gustavostuff/maki-nita/README.md

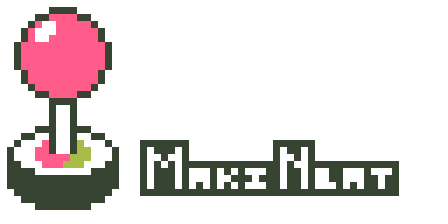
[picture p1: img/logos/logo_v_06_scaled.png]
Logo V6


MakiNeat is a cartridge-based, two-player portable tabletop Arcade. The name comes from _maquinita_ (pronounced very similarly), the Mexican word generally used for an arcade machine. The display is four white 8x8 LED matrices in a 16x16 field. Graphics are 1-bit (LEDs are either ON or OFF).

On a similar spirit as the Magnavox Odyssey and the Vectrex, MakiNeat uses colored, translucent sheets to cover the screen. So the overlay is an extension of the cartridge, part of the game experience. A magnetic marquee runs along the top and the cartridge sits behind it. The [overlays](docs/overlays.md) and [design](docs/design.md) docs cover the sheet and the system netlist.

An AVR128DB28 on a cartridge runs the game and holds the picture (the cartridge is both the system brain and the game data). Four MAX7219 drivers refresh the screen grid.

## Goals

Simple graphics + simple input can still be fun. A stick (and sometimes a button) is all that's needed. Together with cartridges, colored overlays, and a sturdy design, that is the spirit of MakiNeat.

The build is a simple soldering job.

- Parts are through-hole, on a 2.54 mm grid.
- Chips sit in sockets, so a bad one can be swapped.
- Wires leave the board on headers. Two for player controls, another one for power/reset, and one more for the speaker.

Parts are cheap.

- The main system board is a two-layer 100x100 mm board (~5 USD + shipping). The cartridge is an even smaller PCB.
- The screen is four white 8x8 LED matrices (normally less than 1 USD each), and the chips are commonly available (not EOL or NRND).

- Power is any generic/regulated 5 V adapter.

Software is under the MIT License. The hardware design is under the CERN Open Hardware Licence Version 2, Strongly Reciprocal.

## PCBs

Copper tracing is still a WIP for the main PCB, but the full [SKiDL netlist](tools/kicad/main-pcb/skidl/makineat.py) and KiCad files are already under `tools/kicad/main-pcb/` and `tools/kicad/cart-pcb/` (not tested IRL).

Main system PCB, 100x100 mm:

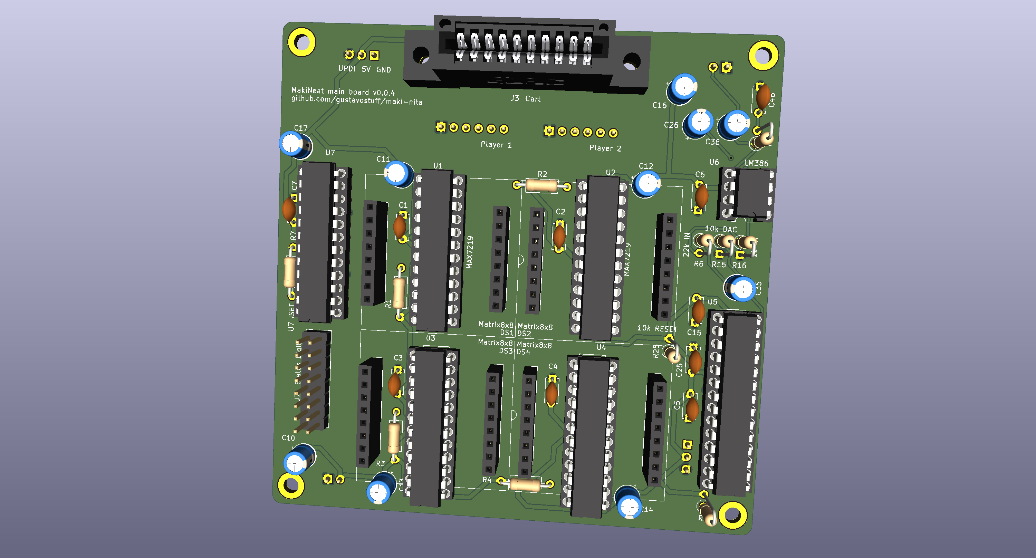
[picture p2: img/pcb/main_pcb_concept.png]
Main PCB concept


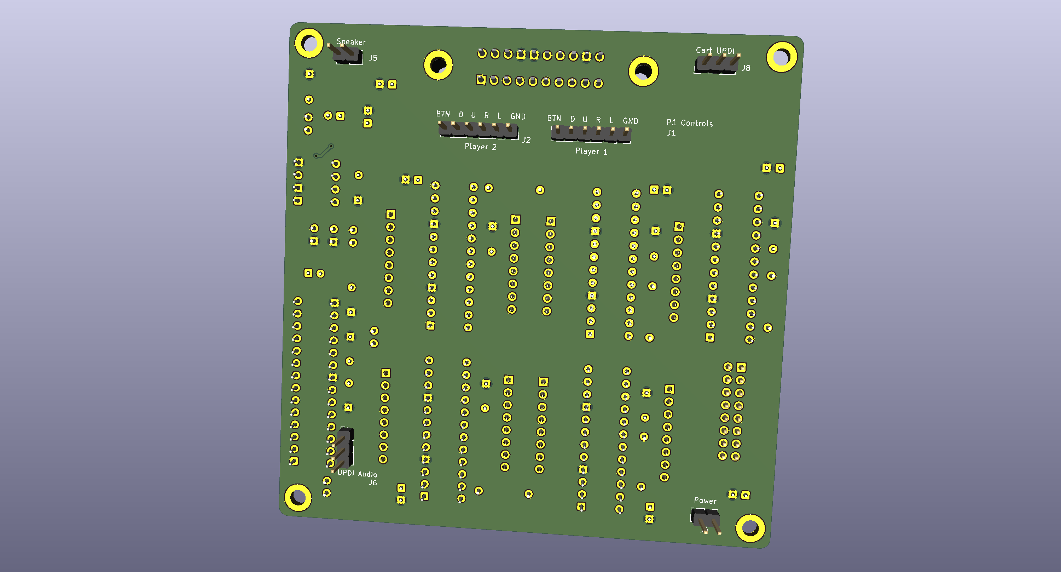
[picture p3: img/pcb/main_pcb_concept_back.png]
Main PCB concept


Cartridge PCB, 44x37 mm:

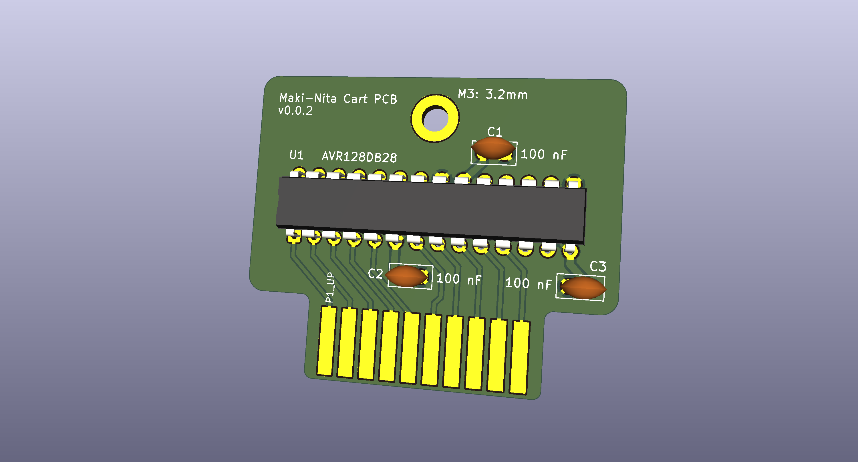
[picture p4: img/pcb/cart_pcb_concept.png]
Cart PCB concept


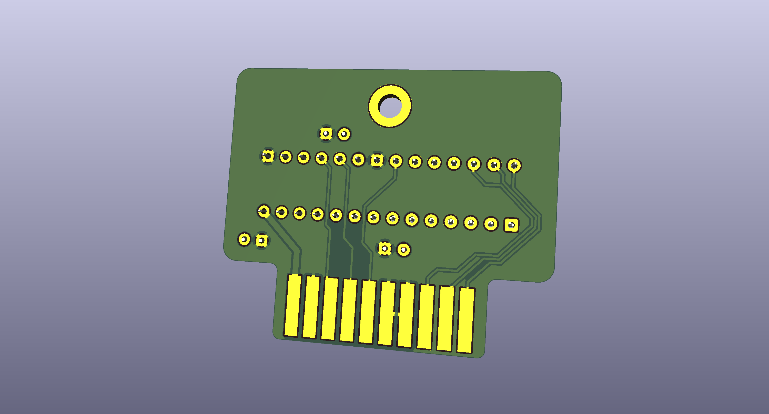
[picture p5: img/pcb/cart_pcb_concept_back.png]
Cart PCB concept back


## Game simulator

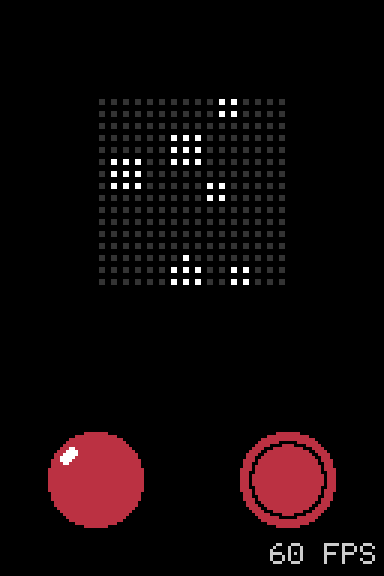
[picture p6: img/sim/sim.png]
Simulator


`tools/sim` is a netlist simulation of the system. The simulator compiles the cartridge's C game code natively on the host to drive the hardware model. This same C code can be directly flashed to the AVR on the cartridge.

SKiDL export writes `tools/kicad/main-pcb/skidl/makineat.net` and updates net classes in `tools/kicad/main-pcb/makineat_v_04.kicad_pro`. See [firmware](docs/firmware.md).

`./sim.sh` opens the UI. The active cart is named in `cart_placed.json`.

## Screen overlay

Physical translucent sheets, placed in front of the white matrix LEDs and status digits, make multi-colored graphics. A single framed overlay holds colored acetate cutouts across both zones, with game labels along the frame:

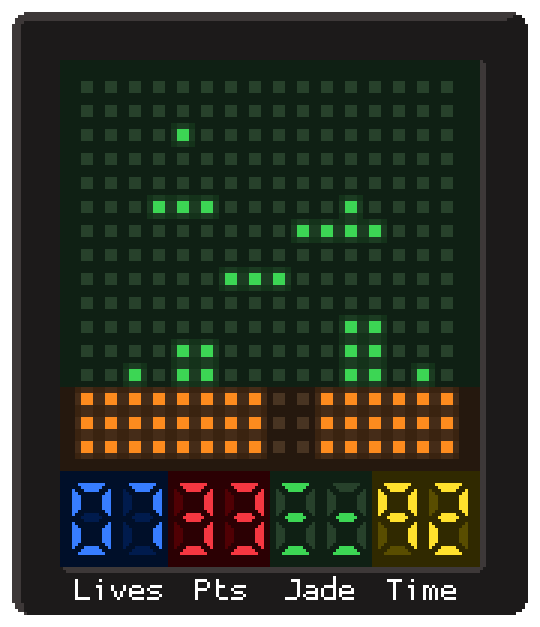
[picture p7: img/acetate_examples/Full_overlay_example.png]
Full overlay example


## Docs

- [Design](docs/design.md) is the system netlist, cart edge, display chain, and audio wiring from SKiDL and KiCad.
- [Firmware](docs/firmware.md) is the game loop, inputs, sound, SDK, and simulator.
- [Overlays](docs/overlays.md) is the colored sheet in front of the field.
- [Future plans](docs/future-plans.md) is the hardware and firmware enhancement roadmap.
- [Status digits](docs/status-digits.md) is the fifth driver and 7-segment display proposal.
- [Driver to matrix pinout](docs/driver_to_matrix_pinout.md) is the MAX7219 and 1088AS LED matrix pinout and activation reference.
