gustavostuff/maki-nita/docs/firmware.md

# Firmware and simulator

Sources live under `tools/fw/`. Cartridge game firmware runs on the cartridge AVR128DB28 at 12 MHz, while system audio synthesis runs on the AVR128DB28 at 20 MHz.

## Game loop and display refresh

The runtime loops at 60 Hz (~16.67 ms per frame). Each pass debounces inputs, executes `game_tick`, and flushes the 16x16 framebuffer across the MAX7219 chain.

The framebuffer is sixteen rows of sixteen bits in `frame[16]`. `pixel`, `pixel_get`, and `clear` form the drawing API. There is no per-pixel brightness in RAM.

DIN is PA4, CLK is PA6, LOAD is PA7. One flush transmits eight digit rows across all four drivers via SPI. During init, firmware configures:
- Decode mode register (0x09) to 0x00 (raw matrix drive, no BCD decode).
- Scan limit register (0x0B) to 0x07 (scan all 8 digits).
- Shutdown register (0x0C) to 0x01 (normal operation).
- Intensity register (0x0A) defaults to 0x0F (full intensity).

### Refresh rate and timing

The MAX7219 uses an autonomous internal RC oscillator with a nominal multiplex scan rate of ~800 Hz (~1.25 ms per full 8-row cycle). This scan frequency is fixed in hardware by internal silicon timing and cannot be reconfigured via register writes.

In relation to the 60 Hz game loop:
- During each 16.67 ms game frame, the MAX7219 hardware autonomously multiplexes the LED rows approximately 13.3 times.
- Because data is double-buffered within the driver registers and latched atomically on the rising edge of LOAD, frame updates never tear or glitch across row scan cycles.
- Operating the hardware multiplexer at ~800 Hz keeps scanning well above human flicker fusion thresholds while completely decoupling LED scanning from CPU frame execution.

## Inputs and debouncing

Player 1 and Player 2 stick and action button nets reach dedicated input pins on the cartridge AVR (ten switch inputs in total). Each switch is active low with an internal pull-up.

Debouncing in `tools/fw/input.c` samples inputs once per 60 Hz tick. Two consecutive disagreeing ticks are required before a state change registers, providing approximately 33 ms of noise immunity.

The planned system brightness control uses debounced input on the Bright button and stick. Tapping the Bright button advances brightness to the next level (wrapping from 15 to 1). Holding the Bright button while pressing stick Up or Down steps the level up or down. Levels are 1, 3, 5, 7, 9, 11, 13, and 15 across all four MAX7219 parts. Zero is not used. Bright and intensity writes are not in the SKiDL netlist yet. The simulator does not model Brightness.

## Sound

Games call `sound(index)` with a catalog index 0 through 255. Index 0 is silent. Sound definitions live in `tools/fw/synth.c`. The cartridge transmits index bytes across the EVENT line as eight low pulses (100 us or 200 us wide). The system audio AVR samples EVENT at 40 kHz, decodes the index, and mixes square wave, triangle wave, and pseudo-random noise channels at 20 kHz into the 10-bit DAC output on PD6.

## Entity SDK

Games can use `tools/fw/entity.c` for sprite movement and collisions, supporting up to 64 active slots. A 32 by 32 coordinate space wraps the screen with an 8 LED/pixel margin on every side. `world_draw` copies the center 16 by 16 playfield into `frame`. Shapes are up to 4 by 4, packed with `SHAPE1` through `SHAPE4`. Functions `entity_spawn`, `entity_step`, `world_tick`, and `world_pairs` manage motion and collision testing.

## Carts

Each cart implements `void game_tick(const Input *in)`. Test carts configured in `cart_placed.json` are `space-shooter`, `paddle`, and `arkaled`.
- Build cartridge firmware with `make -C tools/fw/avr` or `make -C tools/fw/avr CART=paddle`.
- Build system audio firmware with `make -C tools/fw/audio`.

## Flashing hardware (UPDI)

Both microcontrollers (cartridge AVR on J8 and audio AVR on J6) use identical 3-pin headers:
- Pin 1: UPDI
- Pin 2: +5V
- Pin 3: GND

Recommended low-cost programmers:
1. **Adafruit UPDI Friend**: Compact USB-C/micro-USB to UPDI programmer with built-in bidirectional resistor/diode network and selectable 3.3V/5V target power. Connects directly to J6 or J8 via a 3-wire cable.
2. **HiLetgo CH340 USB-UART adapter (SerialUPDI)**: Low-cost USB-to-serial adapter. Connect TX through a 4.7 kohm resistor to RX to form the single bidirectional UPDI line (Pin 1), with 5V on Pin 2 and GND on Pin 3.

Flash commands using `pymcuprog`:
```bash
# Flash cartridge game (with cart seated in J3, programmer plugged into J8):
pymcuprog write -d avr128db28 -t uart -u /dev/ttyACM0 --verify -f tools/fw/avr/game.hex

# Flash console audio synthesis (programmer plugged into J6):
pymcuprog write -d avr128db28 -t uart -u /dev/ttyACM0 --verify -f tools/fw/audio/audio.hex
```

## Simulator

`./sim.sh` builds and launches `tools/sim/makineat-ui`. The netlist model connects simulated cartridge pins to U1 through U4, EVENT, and J5. Host simulation runs at 60 Hz with 12 MHz and 20 MHz timing constants defined in `tools/sim/clocks.h`.
