gustavostuff/maki-nita/acetate_screenshot.png

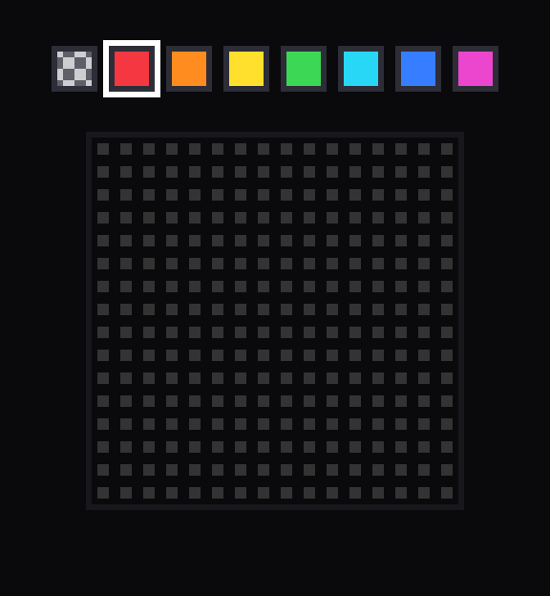
acetate_screenshot.png
