gustavostuff/maki-nita/img/acetate_examples/frog-led.png

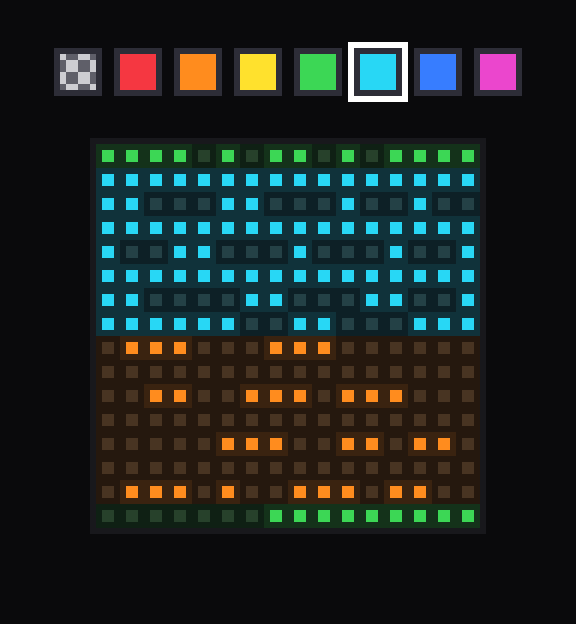
img/acetate_examples/frog-led.png
