gustavostuff/maki-nita/img/acetate_examples/ledtris.png

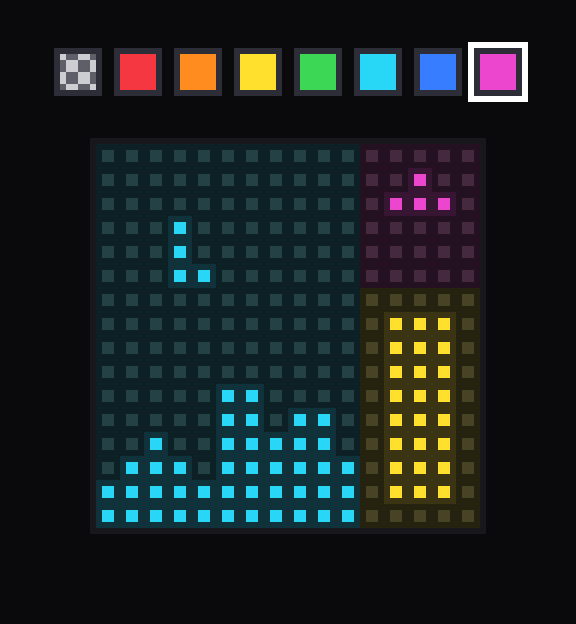
img/acetate_examples/ledtris.png
