gustavostuff/maki-nita/img/acetate_examples/super-led-bros.png

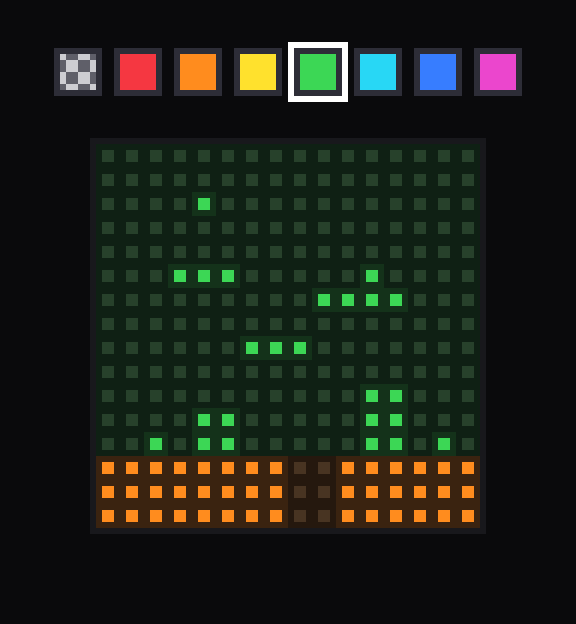
img/acetate_examples/super-led-bros.png
