gustavostuff/maki-nita/img/game_ideas/super-led-bros-grid.png

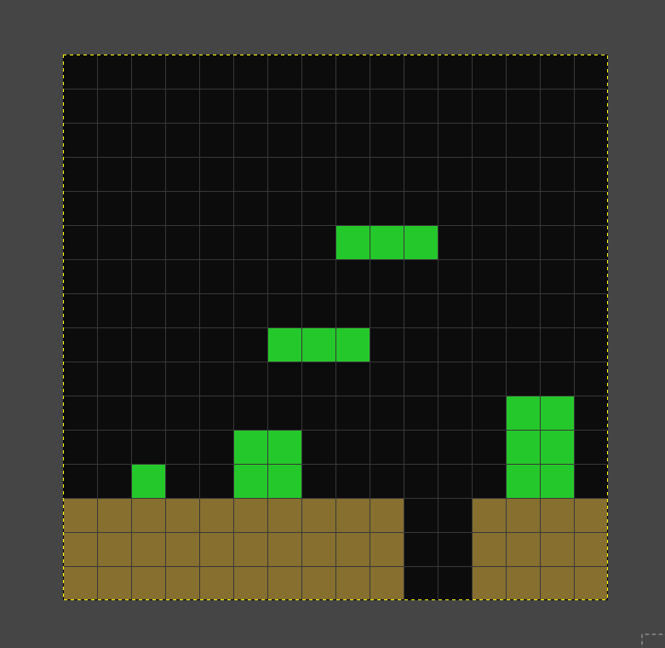
img/game_ideas/super-led-bros-grid.png
