gustavostuff/maki-nita/img/references/JST_XH_power_port.png

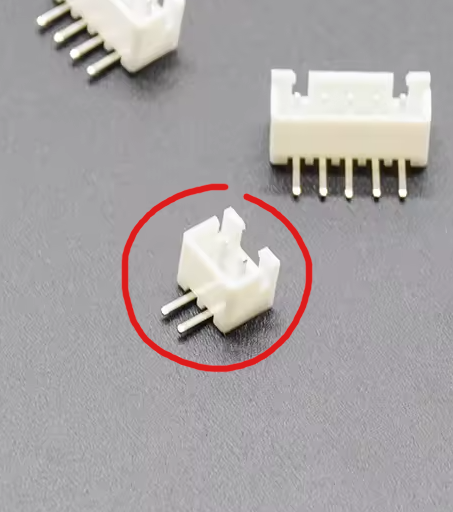
img/references/JST_XH_power_port.png
