gustavostuff/maki-nita/tools/kicad/main-pcb/makineat.kicad_pcb

## KiCad design tools/kicad/main-pcb/makineat.kicad_pcb (2026-10-30, an earlier design)

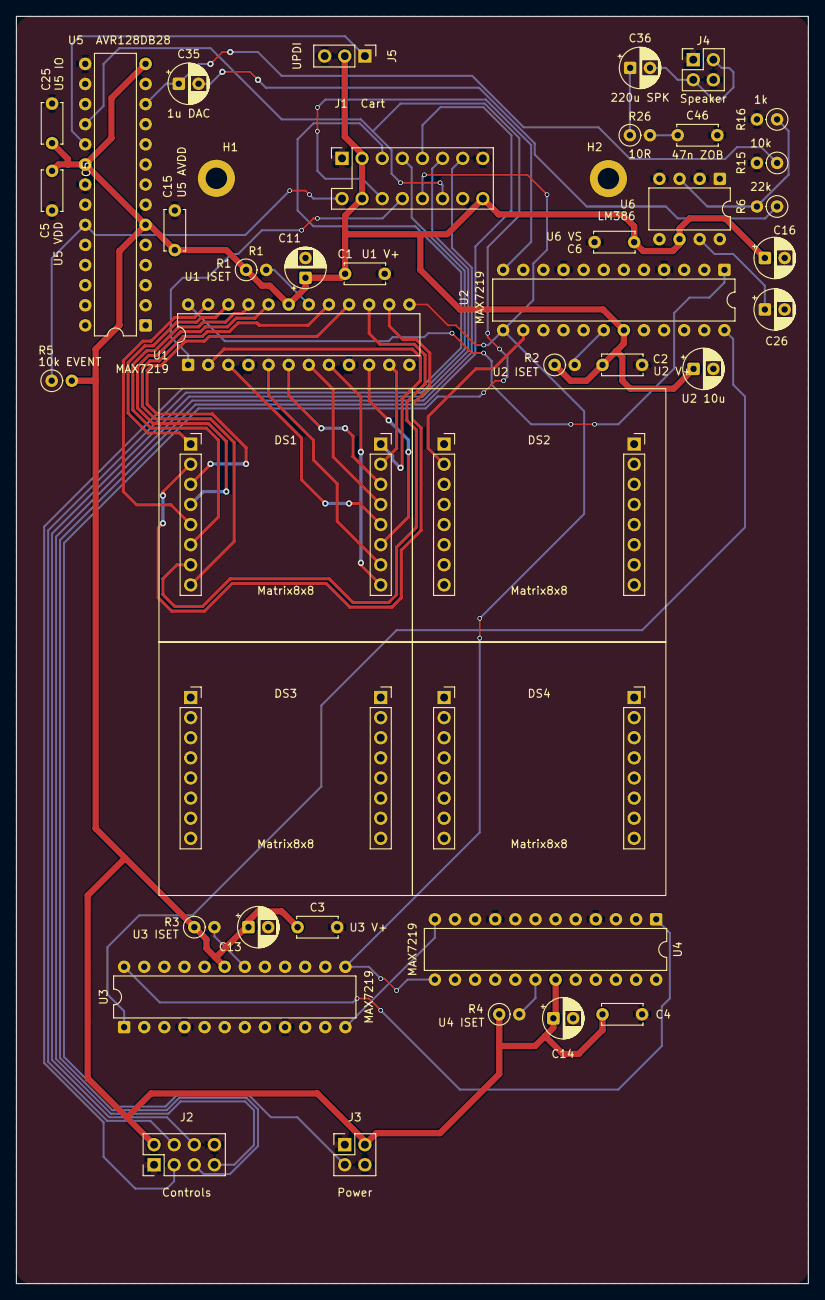
[picture p16: board makineat.kicad_pcb from above]

Board: 2 copper layers, 100.0 x 160.0 mm, 43 parts (0 on the bottom side), 91 nets.

Parts:
C1: U1 V+; C_Disc_D5.0mm_W2.5mm_P5.00mm
C2: U2 V+; C_Disc_D5.0mm_W2.5mm_P5.00mm
C3: U3 V+; C_Disc_D5.0mm_W2.5mm_P5.00mm
C4: U4 V+; C_Disc_D5.0mm_W2.5mm_P5.00mm
C5: U5 VDD; C_Disc_D5.0mm_W2.5mm_P5.00mm
C6: U6 VS; C_Disc_D5.0mm_W2.5mm_P5.00mm
C11: U1 10u; CP_Radial_D5.0mm_P2.50mm
C12: U2 10u; CP_Radial_D5.0mm_P2.50mm
C13: U3; CP_Radial_D5.0mm_P2.50mm
C14: U4 10u; CP_Radial_D5.0mm_P2.50mm
C15: U5 AVDD; C_Disc_D5.0mm_W2.5mm_P5.00mm
C16: U6 VS; CP_Radial_D5.0mm_P2.50mm
C25: U5 IO; C_Disc_D5.0mm_W2.5mm_P5.00mm
C26: U6 BYP; CP_Radial_D5.0mm_P2.50mm
C35: 1u DAC; CP_Radial_D5.0mm_P2.50mm
C36: 220u SPK; CP_Radial_D5.0mm_P2.50mm
C46: 47n ZOB; C_Disc_D5.0mm_W2.5mm_P5.00mm
DS1, DS2, DS3, DS4: Matrix8x8; Matrix8x8_2x8_P2.52mm_R25mm
H1, H2: MountingHole_2.7mm_M2.5_DIN965_Pad
J1: Cart; EDAC_345_MoboSocket_2x8_2.54x5.08mm
J2: Controls; PinHeader_2x04_P2.54mm_Vertical
J3: Power; PinHeader_2x02_P2.54mm_Vertical
J4: Speaker; PinHeader_2x02_P2.54mm_Vertical
J5: UPDI; PinHeader_1x03_P2.54mm_Vertical
R1: U1 ISET; R_Axial_DIN0207_L6.3mm_D2.5mm_P2.54mm_Vertical
R2: U2 ISET; R_Axial_DIN0207_L6.3mm_D2.5mm_P2.54mm_Vertical
R3: U3 ISET; R_Axial_DIN0207_L6.3mm_D2.5mm_P2.54mm_Vertical
R4: U4 ISET; R_Axial_DIN0207_L6.3mm_D2.5mm_P2.54mm_Vertical
R5: 10k EVENT; R_Axial_DIN0207_L6.3mm_D2.5mm_P2.54mm_Vertical
R6: 22k; R_Axial_DIN0207_L6.3mm_D2.5mm_P2.54mm_Vertical
R15: 10k; R_Axial_DIN0207_L6.3mm_D2.5mm_P2.54mm_Vertical
R16: 1k; R_Axial_DIN0207_L6.3mm_D2.5mm_P2.54mm_Vertical
R26: 10R; R_Axial_DIN0207_L6.3mm_D2.5mm_P2.54mm_Vertical
U1, U2, U3, U4: MAX7219; DIP-24_W7.62mm
U5  AVR128DB28: Audio AVR; DIP-28_W7.62mm
U6: LM386; DIP-8_W7.62mm

Connections:
+5V: C1.1, C2.1, C3.1, C4.1, C5.1, C6.1, C11.1, C12.1, C13.1, C14.1, C15.1, C16.1, C25.1, J1.3, J1.4, J1.16, J2.2, J3.2, J5.2, R1.1, R2.1, R3.1, R4.1, R5.2, U1.19, U2.19, U3.19, U4.19, U5 AVR128DB28.6, U5 AVR128DB28.14, U5 AVR128DB28.20, U6.6
AMP: C36.1, R26.1, U6.5
AUD: C35.2, R6.1
AUDIN: R6.2, R16.1, U6.3
AUDIO_UPDI: J5.1, U5 AVR128DB28.19
BUTTON: J1.13, J2.7
BYPASS: C26.1, U6.7
CLK: J1.10, U1.13, U2.13, U3.13, U4.13
DAC: C35.1, R15.1, U5 AVR128DB28.12
DIN: J1.8, U1.1
DOUT_U1: U1.24, U2.1
DOUT_U2: U2.24, U3.1
DOUT_U3: U3.24, U4.1
DOWN: J1.7, J2.4
DS1_C0: DS1.1, U1.22
DS1_C1: DS1.2, U1.14
DS1_C2: DS1.3, U1.16
DS1_C3: DS1.4, U1.20
DS1_C4: DS1.5, U1.23
DS1_C5: DS1.6, U1.21
DS1_C6: DS1.7, U1.15
DS1_C7: DS1.8, U1.17
DS1_R0: DS1.16, U1.2
DS1_R1: DS1.15, U1.11
DS1_R2: DS1.14, U1.6
DS1_R3: DS1.13, U1.7
DS1_R4: DS1.12, U1.3
DS1_R5: DS1.11, U1.10
DS1_R6: DS1.10, U1.5
DS1_R7: DS1.9, U1.8
DS2_C0: DS2.1, U2.22
DS2_C1: DS2.2, U2.14
DS2_C2: DS2.3, U2.16
DS2_C3: DS2.4, U2.20
DS2_C4: DS2.5, U2.23
DS2_C5: DS2.6, U2.21
DS2_C6: DS2.7, U2.15
DS2_C7: DS2.8, U2.17
DS2_R0: DS2.16, U2.2
DS2_R1: DS2.15, U2.11
DS2_R2: DS2.14, U2.6
DS2_R3: DS2.13, U2.7
DS2_R4: DS2.12, U2.3
DS2_R5: DS2.11, U2.10
DS2_R6: DS2.10, U2.5
DS2_R7: DS2.9, U2.8
DS3_C0: DS3.1, U3.22
DS3_C1: DS3.2, U3.14
DS3_C2: DS3.3, U3.16
DS3_C3: DS3.4, U3.20
DS3_C4: DS3.5, U3.23
DS3_C5: DS3.6, U3.21
DS3_C6: DS3.7, U3.15
DS3_C7: DS3.8, U3.17
DS3_R0: DS3.16, U3.2
DS3_R1: DS3.15, U3.11
DS3_R2: DS3.14, U3.6
DS3_R3: DS3.13, U3.7
DS3_R4: DS3.12, U3.3
DS3_R5: DS3.11, U3.10
DS3_R6: DS3.10, U3.5
DS3_R7: DS3.9, U3.8
DS4_C0: DS4.1, U4.22
DS4_C1: DS4.2, U4.14
DS4_C2: DS4.3, U4.16
DS4_C3: DS4.4, U4.20
DS4_C4: DS4.5, U4.23
DS4_C5: DS4.6, U4.21
DS4_C6: DS4.7, U4.15
DS4_C7: DS4.8, U4.17
DS4_R0: DS4.16, U4.2
DS4_R1: DS4.15, U4.11
DS4_R2: DS4.14, U4.6
DS4_R3: DS4.13, U4.7
DS4_R4: DS4.12, U4.3
DS4_R5: DS4.11, U4.10
DS4_R6: DS4.10, U4.5
DS4_R7: DS4.9, U4.8
EVENT: J1.2, R5.1, U5 AVR128DB28.23
GND: C1.2, C2.2, C3.2, C4.2, C5.2, C6.2, C11.2, C12.2, C13.2, C14.2, C15.2, C16.2, C25.2, C26.2, C46.2, J1.1, J1.15, J2.1, J2.8, J3.1, J3.4, J4.1, J4.4, J5.3, R15.2, R16.2, U1.4, U1.9, U2.4, U2.9, U3.4, U3.9, U4.4, U4.9, U5 AVR128DB28.15, U5 AVR128DB28.21, U6.2, U6.4
LEFT: J1.9, J2.5
LOAD: J1.6, U1.12, U2.12, U3.12, U4.12
RESET: J1.12, J3.3, U5 AVR128DB28.18
RIGHT: J1.11, J2.6
SPK: C36.2, J4.2, J4.3
U1_ISET: R1.2, U1.18
U2_ISET: R2.2, U2.18
U3_ISET: R3.2, U3.18
U4_ISET: R4.2, U4.18
UP: J1.5, J2.3
ZOBEL: C46.1, R26.2
