gustavostuff/maki-nita/tools/kicad/main-pcb/makineat_v_04.kicad_pcb

## KiCad design tools/kicad/main-pcb/makineat_v_04.kicad_pcb (2026-10-31)

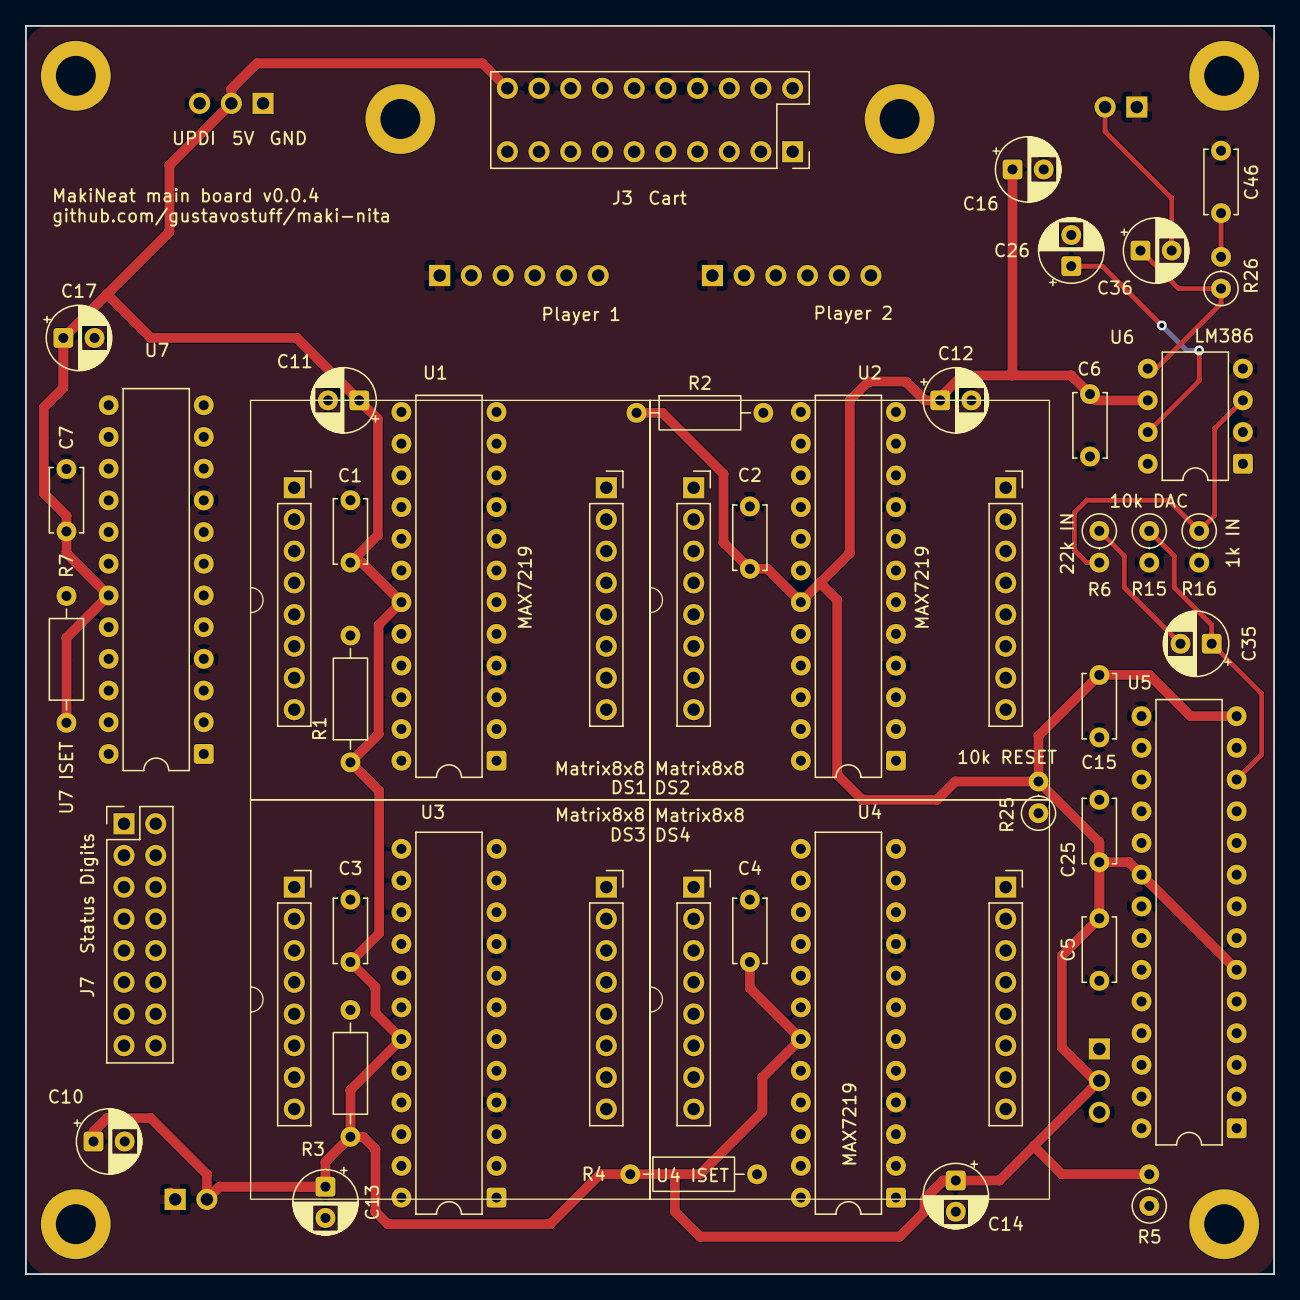
[picture p18: board makineat_v_04.kicad_pcb from above]

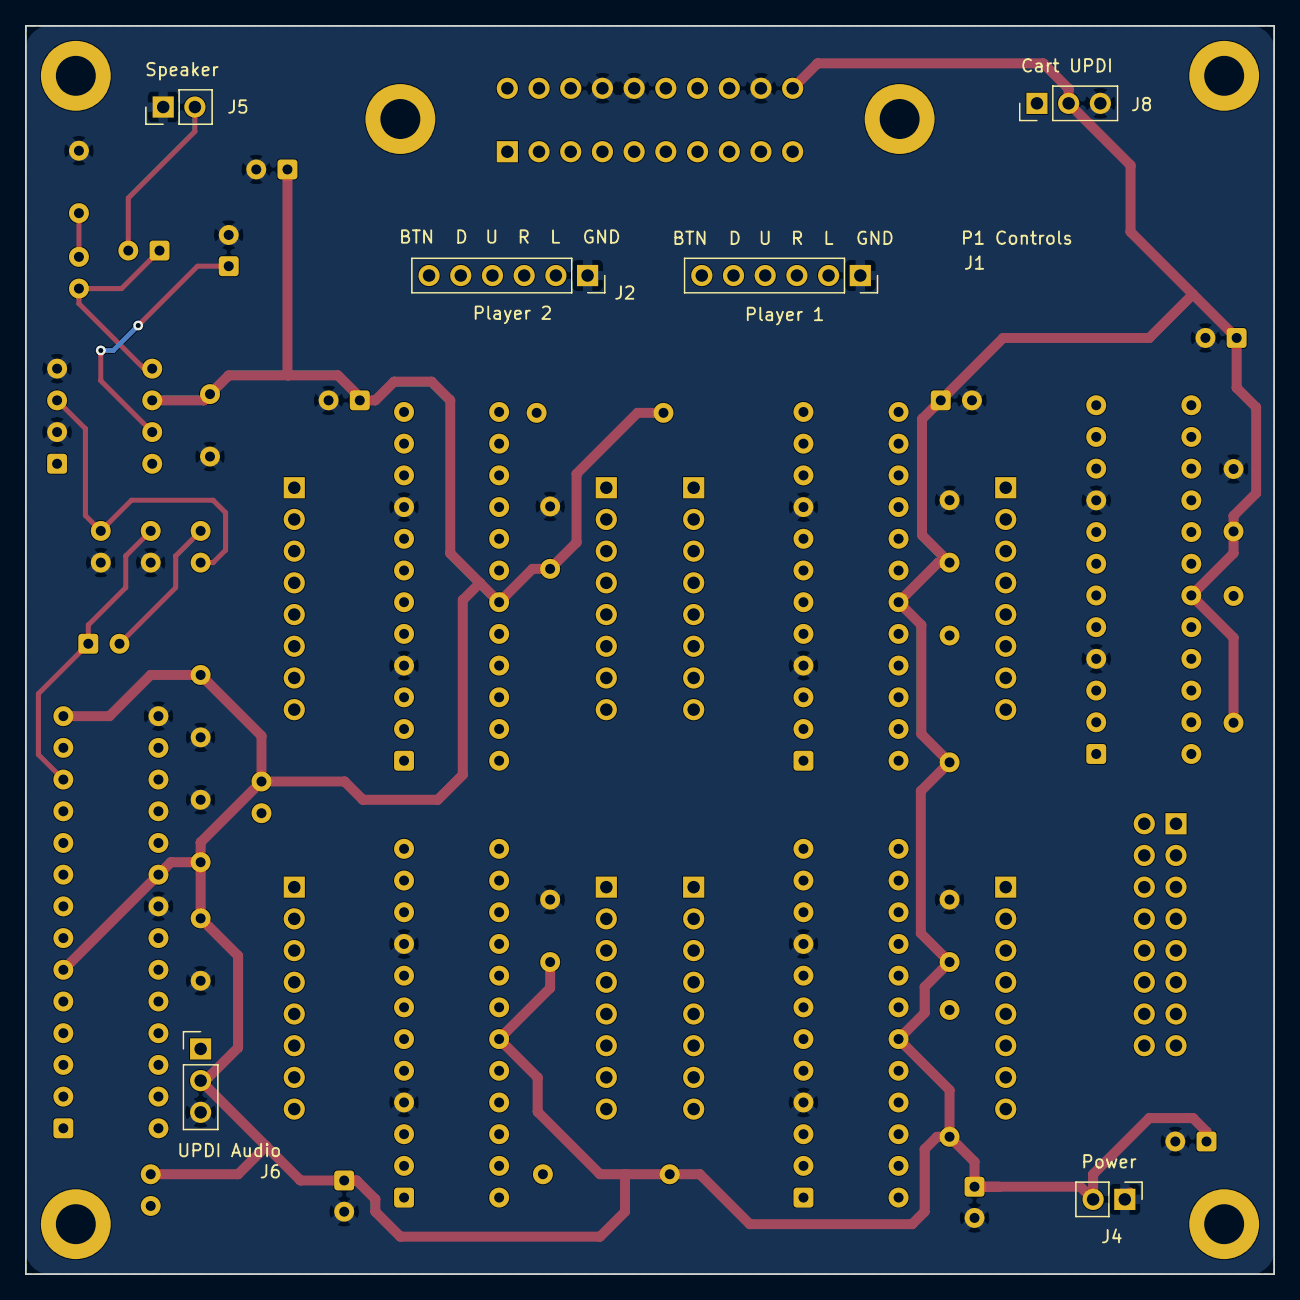
[picture p19: board makineat_v_04.kicad_pcb from below]

Board: 2 copper layers, 100.0 x 100.0 mm, 50 parts (6 on the bottom side), 115 nets.

Parts:
C1: U1 V+; C_Disc_D5.0mm_W2.5mm_P5.00mm
C2: U2 V+; C_Disc_D5.0mm_W2.5mm_P5.00mm
C3: U3 V+; C_Disc_D5.0mm_W2.5mm_P5.00mm
C4: U4 V+; C_Disc_D5.0mm_W2.5mm_P5.00mm
C5: U5 VDD; C_Disc_D5.0mm_W2.5mm_P5.00mm
C6: U6 VS; C_Disc_D5.0mm_W2.5mm_P5.00mm
C7: U7 V+; C_Disc_D5.0mm_W2.5mm_P5.00mm
C10: 470u VCC; CP_Radial_D5.0mm_P2.50mm
C11: U1 10u; CP_Radial_D5.0mm_P2.50mm
C12: U2 10u; CP_Radial_D5.0mm_P2.50mm
C13: U3 10u; CP_Radial_D5.0mm_P2.50mm
C14: U4 10u; CP_Radial_D5.0mm_P2.50mm
C15: U5 AVDD; C_Disc_D5.0mm_W2.5mm_P5.00mm
C16: U6 VS; CP_Radial_D5.0mm_P2.50mm
C17: U7 10u; CP_Radial_D5.0mm_P2.50mm
C25: U5 IO; C_Disc_D5.0mm_W2.5mm_P5.00mm
C26: U6 BYP; CP_Radial_D5.0mm_P2.50mm
C35: 1u DAC; CP_Radial_D5.0mm_P2.50mm
C36: 220u SPK; CP_Radial_D5.0mm_P2.50mm
C46: 47n ZOB; C_Disc_D5.0mm_W2.5mm_P5.00mm
DS1, DS2, DS3, DS4: Matrix8x8; Matrix8x8_2x8_P2.52mm_R25mm
J1: P1 Controls; PinHeader_1x06_P2.54mm_Vertical
J2: P2 Controls; PinHeader_1x06_P2.54mm_Vertical
J3: Cart; EDAC_395_MoboSocket_2x10_2.54x5.08mm
J4: Power; PinHeader_1x02_P2.54mm_Vertical
J5: Speaker; PinHeader_1x02_P2.54mm_Vertical
J6: UPDI Audio; PinHeader_1x03_P2.54mm_Vertical
J7: Status Digits; PinHeader_2x08_P2.54mm_Vertical
J8: Cart UPDI; PinHeader_1x03_P2.54mm_Vertical
R1: U1 ISET; R_Axial_DIN0207_L6.3mm_D2.5mm_P10.16mm_Horizontal
R2: U2 ISET; R_Axial_DIN0207_L6.3mm_D2.5mm_P10.16mm_Horizontal
R3: U3 ISET; R_Axial_DIN0207_L6.3mm_D2.5mm_P10.16mm_Horizontal
R4: U4 ISET; R_Axial_DIN0207_L6.3mm_D2.5mm_P10.16mm_Horizontal
R5: 10k EVENT; R_Axial_DIN0207_L6.3mm_D2.5mm_P2.54mm_Vertical
R6: 22k IN; R_Axial_DIN0207_L6.3mm_D2.5mm_P2.54mm_Vertical
R7: U7 ISET; R_Axial_DIN0207_L6.3mm_D2.5mm_P10.16mm_Horizontal
R15: 10k DAC; R_Axial_DIN0207_L6.3mm_D2.5mm_P2.54mm_Vertical
R16: 1k IN; R_Axial_DIN0207_L6.3mm_D2.5mm_P2.54mm_Vertical
R25: 10k RESET; R_Axial_DIN0207_L6.3mm_D2.5mm_P2.54mm_Vertical
R26: 10R ZOB; R_Axial_DIN0207_L6.3mm_D2.5mm_P2.54mm_Vertical
U1, U2, U3, U4, U7: MAX7219; DIP-24_W7.62mm
U5: Audio AVR; DIP-28_W7.62mm
U6: LM386; DIP-8_W7.62mm

Connections:
+5V: C1.1, C2.1, C3.1, C4.1, C5.1, C6.1, C7.1, C10.1, C11.1, C12.1, C13.1, C14.1, C15.1, C16.1, C17.1, C25.1, J3.20, J4.2, J6.2, J8.2, R1.1, R2.1, R3.1, R4.1, R5.2, R7.1, R25.2, U1.19, U2.19, U3.19, U4.19, U5.6, U5.14, U5.20, U6.6, U7.19
AMP: C36.1, R26.1, U6.5
AUD: C35.2, R6.1
AUDIN: R6.2, R16.1, U6.3
AUDIO_UPDI: J6.1, U5.19
BYPASS: C26.1, U6.7
CLK: J3.2, U1.13, U2.13, U3.13, U4.13, U7.13
DAC: C35.1, R15.1, U5.12
DIN: J3.6, U1.1
DOUT_U1: U1.24, U2.1
DOUT_U2: U2.24, U3.1
DOUT_U3: U3.24, U4.1
DOUT_U4: U4.24, U7.1
DS1_0: DS1.0, U1.17
DS1_1: DS1.1, U1.15
DS1_2: DS1.2, U1.11
DS1_3: DS1.3, U1.22
DS1_4: DS1.4, U1.7
DS1_5: DS1.5, U1.21
DS1_6: DS1.6, U1.20
DS1_7: DS1.7, U1.2
DS1_8: DS1.8, U1.3
DS1_9: DS1.9, U1.5
DS1_A: DS1.A, U1.14
DS1_B: DS1.B, U1.16
DS1_C: DS1.C, U1.8
DS1_D: DS1.D, U1.23
DS1_E: DS1.E, U1.10
DS1_F: DS1.F, U1.6
DS2_0: DS2.0, U2.17
DS2_1: DS2.1, U2.15
DS2_2: DS2.2, U2.11
DS2_3: DS2.3, U2.22
DS2_4: DS2.4, U2.7
DS2_5: DS2.5, U2.21
DS2_6: DS2.6, U2.20
DS2_7: DS2.7, U2.2
DS2_8: DS2.8, U2.3
DS2_9: DS2.9, U2.5
DS2_A: DS2.A, U2.14
DS2_B: DS2.B, U2.16
DS2_C: DS2.C, U2.8
DS2_D: DS2.D, U2.23
DS2_E: DS2.E, U2.10
DS2_F: DS2.F, U2.6
DS3_0: DS3.0, U3.17
DS3_1: DS3.1, U3.15
DS3_2: DS3.2, U3.11
DS3_3: DS3.3, U3.22
DS3_4: DS3.4, U3.7
DS3_5: DS3.5, U3.21
DS3_6: DS3.6, U3.20
DS3_7: DS3.7, U3.2
DS3_8: DS3.8, U3.3
DS3_9: DS3.9, U3.5
DS3_A: DS3.A, U3.14
DS3_B: DS3.B, U3.16
DS3_C: DS3.C, U3.8
DS3_D: DS3.D, U3.23
DS3_E: DS3.E, U3.10
DS3_F: DS3.F, U3.6
DS4_0: DS4.0, U4.17
DS4_1: DS4.1, U4.15
DS4_2: DS4.2, U4.11
DS4_3: DS4.3, U4.22
DS4_4: DS4.4, U4.7
DS4_5: DS4.5, U4.21
DS4_6: DS4.6, U4.20
DS4_7: DS4.7, U4.2
DS4_8: DS4.8, U4.3
DS4_9: DS4.9, U4.5
DS4_A: DS4.A, U4.14
DS4_B: DS4.B, U4.16
DS4_C: DS4.C, U4.8
DS4_D: DS4.D, U4.23
DS4_E: DS4.E, U4.10
DS4_F: DS4.F, U4.6
DS5_0: J7.1, U7.17
DS5_1: J7.2, U7.15
DS5_2: J7.3, U7.11
DS5_3: J7.4, U7.22
DS5_4: J7.9, U7.7
DS5_5: J7.10, U7.21
DS5_6: J7.11, U7.20
DS5_7: J7.12, U7.2
DS5_8: J7.5, U7.3
DS5_9: J7.6, U7.5
DS5_A: J7.7, U7.14
DS5_B: J7.8, U7.16
DS5_C: J7.13, U7.8
DS5_D: J7.14, U7.23
DS5_E: J7.15, U7.10
DS5_F: J7.16, U7.6
EVENT: J3.16, R5.1, U5.23
GND: C1.2, C2.2, C3.2, C4.2, C5.2, C6.2, C7.2, C10.2, C11.2, C12.2, C13.2, C14.2, C15.2, C16.2, C17.2, C25.2, C26.2, C46.2, J1.1, J2.1, J3.8, J3.10, J3.18, J4.1, J5.1, J6.3, J8.3, R15.2, R16.2, U1.4, U1.9, U2.4, U2.9, U3.4, U3.9, U4.4, U4.9, U5.15, U5.21, U6.2, U6.4, U7.4, U7.9
LOAD: J3.4, U1.12, U2.12, U3.12, U4.12, U7.12
P1_BTN: J1.6, J3.11
P1_DOWN: J1.5, J3.13
P1_LEFT: J1.2, J3.19
P1_RIGHT: J1.3, J3.17
P1_UP: J1.4, J3.15
P2_BTN: J2.6, J3.1
P2_DOWN: J2.5, J3.3
P2_LEFT: J2.2, J3.9
P2_RIGHT: J2.3, J3.7
P2_UP: J2.4, J3.5
RESET: J3.14, R25.1, U5.18
SPK: C36.2, J5.2
U1_ISET: R1.2, U1.18
U2_ISET: R2.2, U2.18
U3_ISET: R3.2, U3.18
U4_ISET: R4.2, U4.18
U7_ISET: R7.2, U7.18
UPDI: J3.12, J8.1
ZOBEL: C46.1, R26.2
