gustavostuff/maki-nita/tools/fw/over.h

#ifndef FW_OVER_H
#define FW_OVER_H

#include "input.h"

/*
 * The end picture shared by every cart. A face, then the round's score.
 * over_start draws it and holds the button for one second.
 * over_tick returns 1 when the button may start the next round.
 */

void over_clear(void);
void over_start(void);
int over_tick(const Input *in);

#endif
