gustavostuff/maki-nita/(commit log)

2026-10-22 Updated rendering performance issues (Sim) + docs
    [main.c]
2026-10-22 Working on SKiDL + KiCad flow
    [maki-nita.kicad_pcb, maki-nita.kicad_sch]
2026-10-22 Going back to 16x16 screen
    [maki-nita.kicad_pcb]
2026-10-22 Added binary score to the game
    [maki-nita.kicad_pcb]
2026-10-22 Polished game a bit more
    [maki-nita.kicad_pcb]
2026-10-22 Working on cartridge design
    [maki-nita.kicad_pcb]
2026-10-22 Working on 16 golden finger cart
    [maki-nita-cart.kicad_pcb, maki-nita-cart.kicad_sch]
2026-10-22 Non reversible cart gold fingers
    [maki-nita.kicad_pcb]
2026-10-22 Add the power header and socket model.
    [maki-nita-cart.kicad_pcb, maki-nita.kicad_pcb]
2026-10-22 Folder reorg
    [maki-nita-cart.kicad_pcb, maki-nita-cart.kicad_sch, maki-nita.kicad_pcb, maki-nita.kicad_sch]
2026-10-23 Change PCB concept image in README
    Updated image reference for cartridge PCB concept.
2026-10-23 Reorganized docs
    [maki-nita-cart.kicad_pcb]
2026-10-24 Added the 2x2 speaker header and quieter audio path
    [maki-nita.kicad_pcb]
2026-10-24 Working on main PCB
    [maki-nita.kicad_pcb]
2026-10-24 Working on main PCB issues
    [maki-nita.kicad_pcb]
2026-10-24 Updating main PCB net classes
    [maki-nita.kicad_pcb]
2026-10-24 Imported missing components into main PCB
    [maki-nita.kicad_pcb]
2026-10-24 Switched to larger PCB size (Eurocard 3U)
    [maki-nita.kicad_pcb]
2026-10-24 Added 3D model for 8x8 matrices
    [maki-nita.kicad_pcb]
2026-10-24 More realistic 3D models for matrices
    [maki-nita.kicad_pcb]
2026-10-24 Updated PCB image
    [maki-nita.kicad_pcb]
2026-10-25 Updated transformation for 3D model
    [maki-nita.kicad_pcb]
2026-10-25 Clarify PCB design status in README
    Updated PCB section to clarify netlist status and copper traces.
2026-10-25 Document brightness and 12/20 MHz clocks
    [maki-nita_v_02.kicad_pcb]
2026-10-25 Document trace signal/noise rules
    [maki-nita_v_02.kicad_pcb]
2026-10-25 Updating some SKiDL/KiCad stuff
    [maki-nita-cart.kicad_pcb, maki-nita.kicad_pcb, maki-nita_v_02.kicad_pcb]
2026-10-25 Updating some README + imgs
    [maki-nita-cart.kicad_pcb]
2026-10-26 Updating main PCB size docs
2026-10-26 Reduced docs content + more copper traces
    [maki-nita_v_02.kicad_pcb, maki-nita_v_03_no_copper.kicad_pcb]
2026-10-26 Polishing some docs + PCB changes
    [maki-nita-cart.kicad_pcb, maki-nita.kicad_pcb, maki-nita_v_02.kicad_pcb, maki-nita_v_03_no_copper.kicad_pcb]
2026-10-27 Fixed README imgs + LED colors in Sim
    [main.c]
2026-10-27 Update cartridge PCB dimensions in README
2026-10-27 Updated docs to 2 Player
    [maki-nita_v_03.kicad_pcb]
2026-10-27 Working on SKiDL flow for 2 players
2026-10-27 Working on new footprints for 2 players (v_03)
    [maki-nita_v_03.kicad_pcb]
2026-10-27 PCB updates + docs
    [maki-nita-cart.kicad_pcb]
2026-10-27 Update cart edge pinout and PCB routing
    [maki-nita-cart.kicad_pcb, maki-nita_v_03.kicad_pcb]
2026-10-27 Update imgs + PCB models
    [maki-nita_v_03.kicad_pcb]
2026-10-28 Fixed netlist to match Matrix pinout
    [maki-nita_v_03.kicad_pcb]
2026-10-28 Update README to clarify PCB description
2026-10-28 Updated net classes
    [maki-nita_v_03.kicad_pcb]
2026-10-28 Better PCB placement + some logos
    [maki-nita_v_03.kicad_pcb]
2026-10-28 Fixed text issue in text-test/ game
    [text.c]
2026-10-28 File re-org for kicad folder
    [maki-nita-cart.kicad_pcb, maki-nita.kicad_pcb, maki-nita_v_03.kicad_pcb]
2026-10-28 Working on pinout for matrices
    [maki-nita_v_03.kicad_pcb]
2026-10-29 Added notch to matrix lib footprint
    [maki-nita_v_03.kicad_pcb]
2026-10-29 Corret pin orientation for matrices
    [maki-nita_v_03.kicad_pcb]
2026-10-29 Updated matrix <-> MAX7219 wiring
    [maki-nita_v_03.kicad_pcb]
2026-10-29 Larger overlay + doc changes
    [maki-nita_v_03.kicad_pcb]
2026-10-30 Added drive <-> matrix pinout doc
    [maki-nita_v_03.kicad_pcb]
2026-10-30 Added 7-segment netlist + power board changes
    [maki-nita_v_03.kicad_pcb]
2026-10-30 Add U7 driver and update connector footprints
    [maki-nita_v_03.kicad_pcb]
2026-10-30 More net classes + imgs
    [maki-nita_v_03.kicad_pcb]
2026-10-30 Updated J1/J2/J3 references
    [maki-nita_v_03.kicad_pcb]
2026-10-30 Fixed various electrical issues
    [maki-nita_v_03.kicad_pcb]
2026-10-30 Make audio connector 2-pin
    [maki-nita_v_04.kicad_pcb]
2026-10-30 Rest of the rebrand to 'MakiNeat'
    [makineat-cart.kicad_pcb, makineat-cart.kicad_sch, makineat.kicad_pcb, makineat.kicad_sch, makineat_v_02.kicad_pcb, makineat_v_03.kicad_pcb, makineat_v_04.kicad_pcb]
2026-10-31 README imgs and PCB updates
    [makineat_v_04.kicad_pcb]
